cjsatuforc/drone_project/README.md

# drone_project

Building a quadcopter based on the Arduino 101 as a flight controller
