cjsatuforc/drone_project/D$TEMPLATE/Report.tex

%% ----------------------------------------------------------------
%% Report.tex
%% ---------------------------------------------------------------- 
\documentclass{ecsreport}      % Use the Report Style
\graphicspath{{../Figures/}}   % Location of your graphics files
\usepackage{natbib}            % Use Natbib style for the refs.
\usepackage{longtable}         % Use long table to span tables across pages
\hypersetup{colorlinks=false}   % Set to false for black/white printing
\input{Definitions}            % Include your abbreviations
\usepackage{dirtytalk}
\usepackage[utf8]{inputenc}
\usepackage{siunitx}
\usepackage{graphicx}
\usepackage{listings}
\usepackage{color}
\usepackage{appendix}
%\usepackage{minted}
\usepackage{color}
%\usepackage{gensymb}
\usepackage{dirtytalk}
\usepackage{float}

\usepackage{pdfpages}

\definecolor{dkgreen}{rgb}{0,0.6,0}
\definecolor{gray}{rgb}{0.5,0.5,0.5}
\definecolor{mauve}{rgb}{0.58,0,0.82}
\definecolor{lightgray}{rgb}{.9,.9,.9}
\definecolor{darkgray}{rgb}{.4,.4,.4}
\definecolor{purple}{rgb}{0.65, 0.12, 0.82}

\lstset{frame=tb,
  aboveskip=3mm,
  belowskip=3mm,
  showstringspaces=false,
  columns=flexible,
  basicstyle={\small\ttfamily},
  numberstyle=\tiny\color{gray},
  keywordstyle=\color{blue},
  commentstyle=\color{dkgreen},
  stringstyle=\color{mauve},
  breaklines=true,
  breakatwhitespace=true,
  tabsize=3,
  numbers=left
}

\lstdefinelanguage{JavaScript}{
  keywords={break, case, catch, continue, debugger, default, delete, do, else, false, finally, for, function, if, in, instanceof, new, null, return, switch, this, throw, true, try, typeof, var, void, while, with},
  morecomment=[l]{//},
  morecomment=[s]{/*}{*/},
  morestring=[b]',
  morestring=[b]",
  ndkeywords={class, export, boolean, throw, implements, import, this},
  keywordstyle=\color{blue}\bfseries,
  ndkeywordstyle=\color{darkgray}\bfseries,
  identifierstyle=\color{black},
  commentstyle=\color{purple}\ttfamily,
  stringstyle=\color{red}\ttfamily,
  sensitive=true
}

\newcommand\invisiblesection[1]{%
	\refstepcounter{chapter}%
	\addcontentsline{toc}{chapter}{\protect\numberline{\thechapter}#1}%
	\sectionmark{#1}}

%% ----------------------------------------------------------------
\begin{document}

\frontmatter
\pagenumbering{arabic}
\title      {D4 Individual Report:\\ Invention for Transporting Cargo using Helicopter Engineering kNowhow}
\authors    {\texorpdfstring
             {\href{mailto:jw14g15@soton.ac.uk}{Jemma Watson}}
            {Jemma Watson}       
            }
\addresses  {\groupname\\\deptname\\\univname}
\date       {\today}
\subject    {}
\keywords   {}
%\maketitle

\tableofcontents 

%\includepdf[pages={1}, angle=-90, offset=1in -1in]{inventory.pdf}
\includepdf[pages={1},pagecommand={\thispagestyle{plain}\invisiblesection{Inventory Content}}, angle=-90, offset=-1in -1in]{inventory.pdf} \label{Contents Inventory}

\includepdf[pages={1}, angle=-90, offset=1in -1in, pagecommand={\thispagestyle{plain}\invisiblesection{Gantt Chart}}]{Chart.pdf}
\includepdf[pages={1}, offset=-1in -1in, pagecommand={\thispagestyle{plain}\invisiblesection{Transmitter Wiring Diagram}}]{TRANSMITTERcurves_bb.pdf}
\includepdf[pages={1}, offset=1in -1in, pagecommand={\thispagestyle{plain}\invisiblesection{Transmitter Schematics}}]{TRANSMITTER_schem.pdf}
\includepdf[pages={1}, angle=-90, offset=-1in -1in, pagecommand={\thispagestyle{plain}\invisiblesection{Quadcopter Wiring Diagram}}]{drone_bb.pdf}
\includepdf[pages={1}, angle=-90, offset=1in -1in, pagecommand={\thispagestyle{plain}\invisiblesection{Quadcopter Schematics}}]{drone_schem.pdf}

\invisiblesection{Conclusion}\thispagestyle{plain}
\textbf{Conclusion}\\

There have been a number of changes made since my initial proposal; foremost the level of complexity of my drone. In just six weeks since receiving the Arduino 101, I’ve managed to design, build, program, and fly my very own drone. \\
Some of my initial plans were changed along the way. For example, my decision to use a Raspberry Pi connected to an Xbox controller was eventually scrapped in favour of making my own remote control transmitter with some joystick modules, buttons, and an Arduino Uno. I’ve also faced many mechanical issues whilst constructing the drone, resulting in solutions like cutting my own acrylic base plate to attach the Arduino to, and making my own standoffs to house the battery. And of course, what project would be complete without spontaneous hardware failures a week before submission? Fortunately speedy delivery times meant I was able to replace the failed ESC, and get the drone back in the air with a just hours to spare.
At the moment I have a drone that exhibits stable flight. I fully intend on continuing this project, and adding all the cool features I’d planned (what kind of drone doesn’t need a nerf gun?!). The beauty of using the Arduino 101 as a flight controller is the potential to grow and adapt the project in any direction I want to take it. \\
Finally, I would just like to thank everyone involved at Devpost and Intel for giving me the opportunity to do this! I’ve not only expanded my skills as a programmer, but also how to manage my time during a long project – something that will definitely come in useful for my University Electronics 3rd Year project in September!

\end{document}
%% ----------------------------------------------------------------
