cjsatuforc/drone_project/PINS.pptx

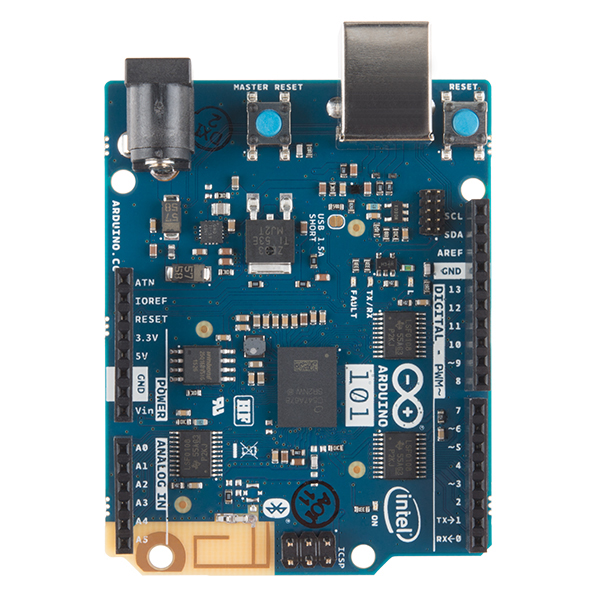
[picture p2: figure]

SCL

SDA

SCK

MISO

MOSI

CE

CSN

INT 2
