cjsatuforc/drone_project/frame/template.pdf

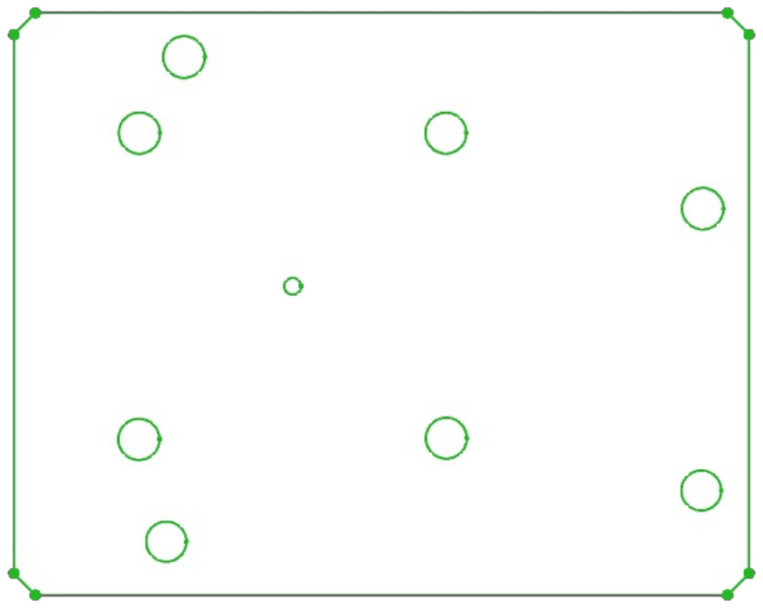
[picture p3: page 1]
