cjsatuforc/drone_project/frame/template2.pdf

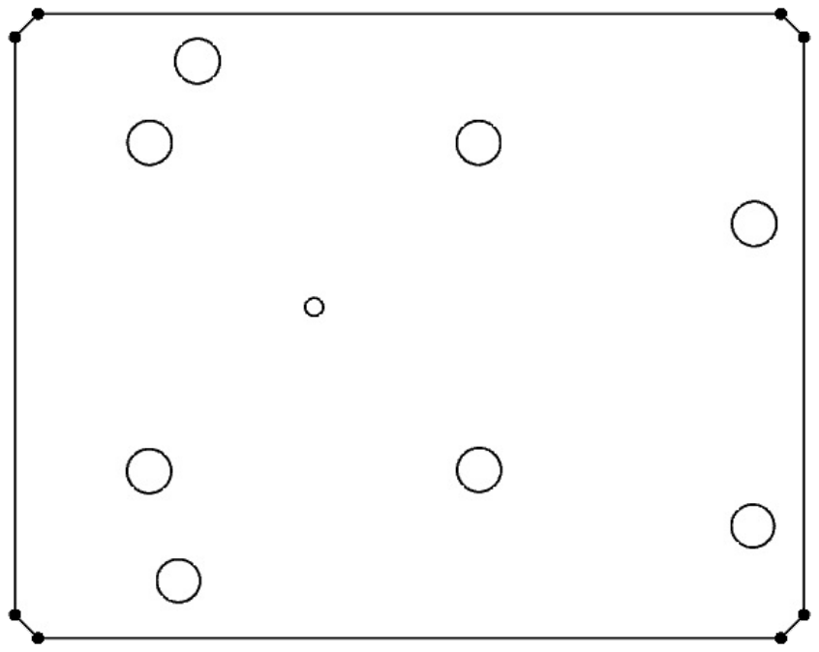
[picture p4: page 1]
