cjsatuforc/drone_project/D$TEMPLATE/figures/display.jpg

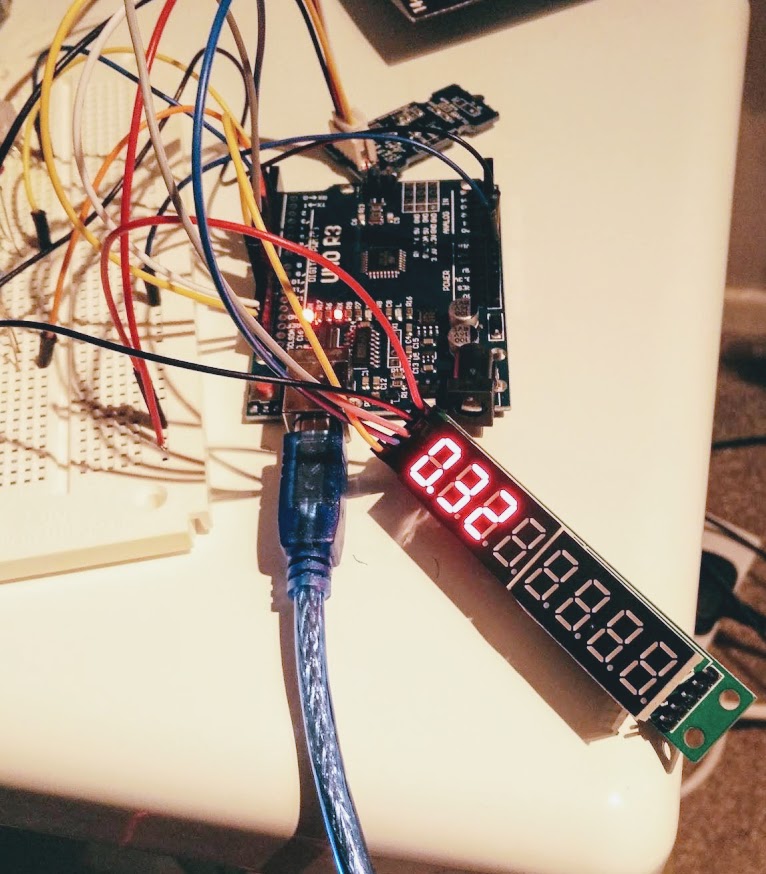
D$TEMPLATE/figures/display.jpg
