cjsatuforc/drone_project/D$TEMPLATE/figures/IMU.png

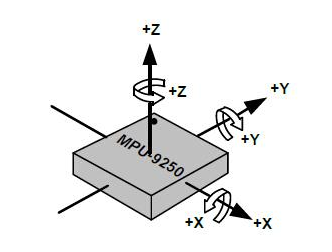
D$TEMPLATE/figures/IMU.png
