cjsatuforc/drone_project/D$TEMPLATE/figures/osc1.png

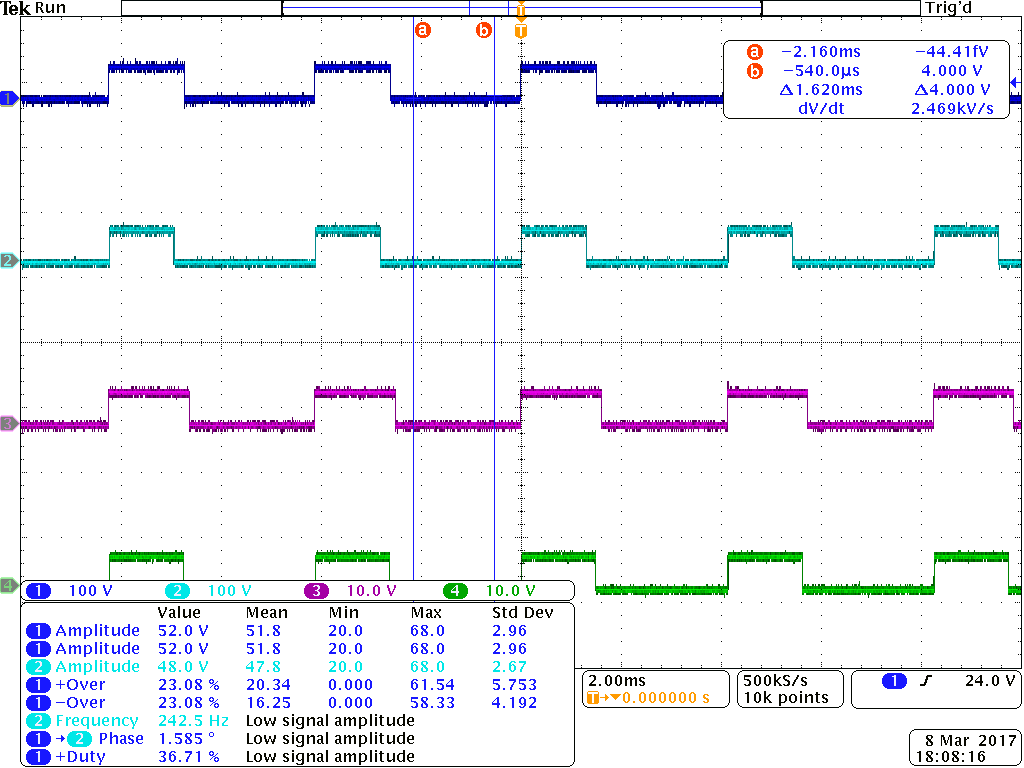
D$TEMPLATE/figures/osc1.png
