cjsatuforc/drone_project/D$TEMPLATE/figures/osc2.png

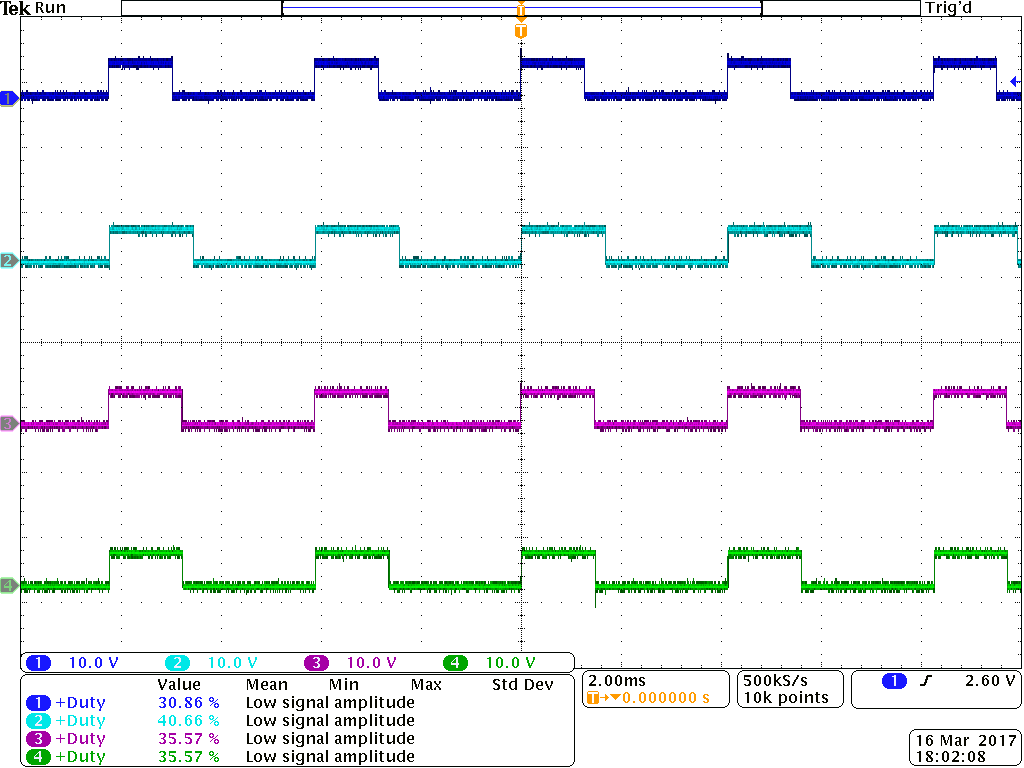
D$TEMPLATE/figures/osc2.png
