cjsatuforc/drone_project/D$TEMPLATE/figures/osc3.png

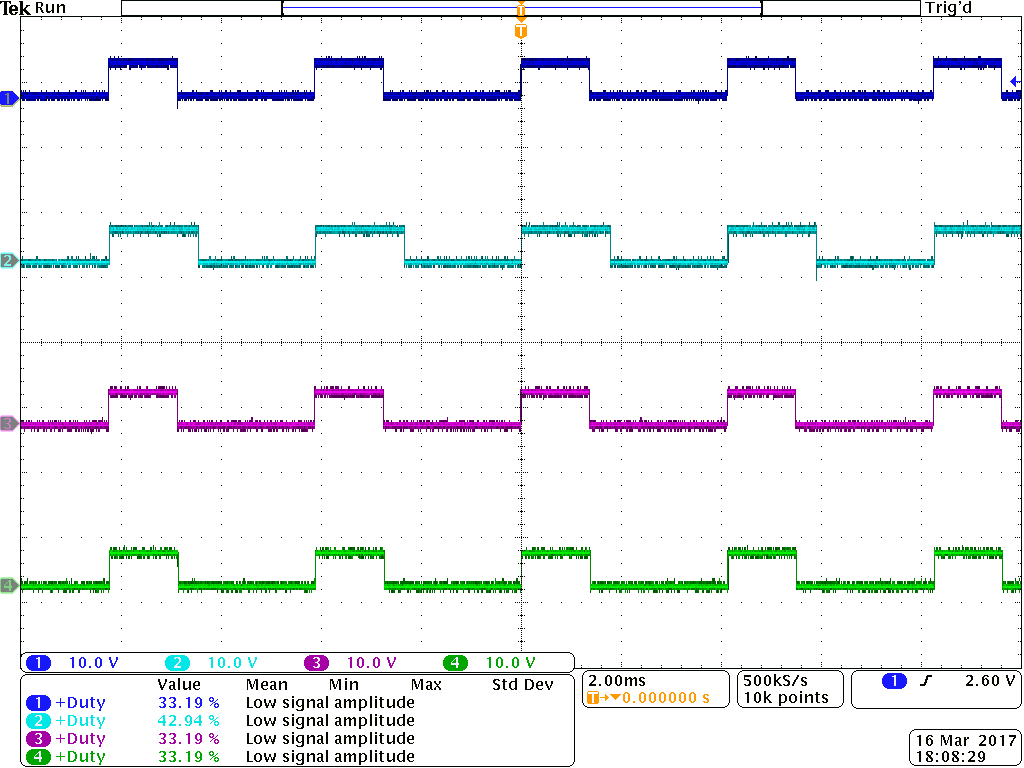
D$TEMPLATE/figures/osc3.png
