cjsatuforc/drone_project/D$TEMPLATE/figures/rpy_maths.png

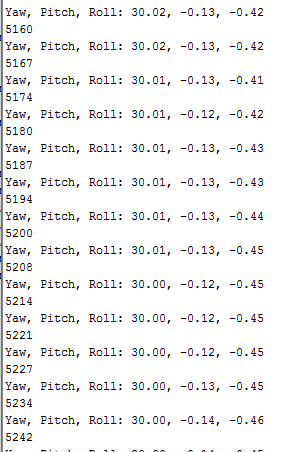
D$TEMPLATE/figures/rpy_maths.png
