cjsatuforc/drone_project/fritz/drone_bb.png

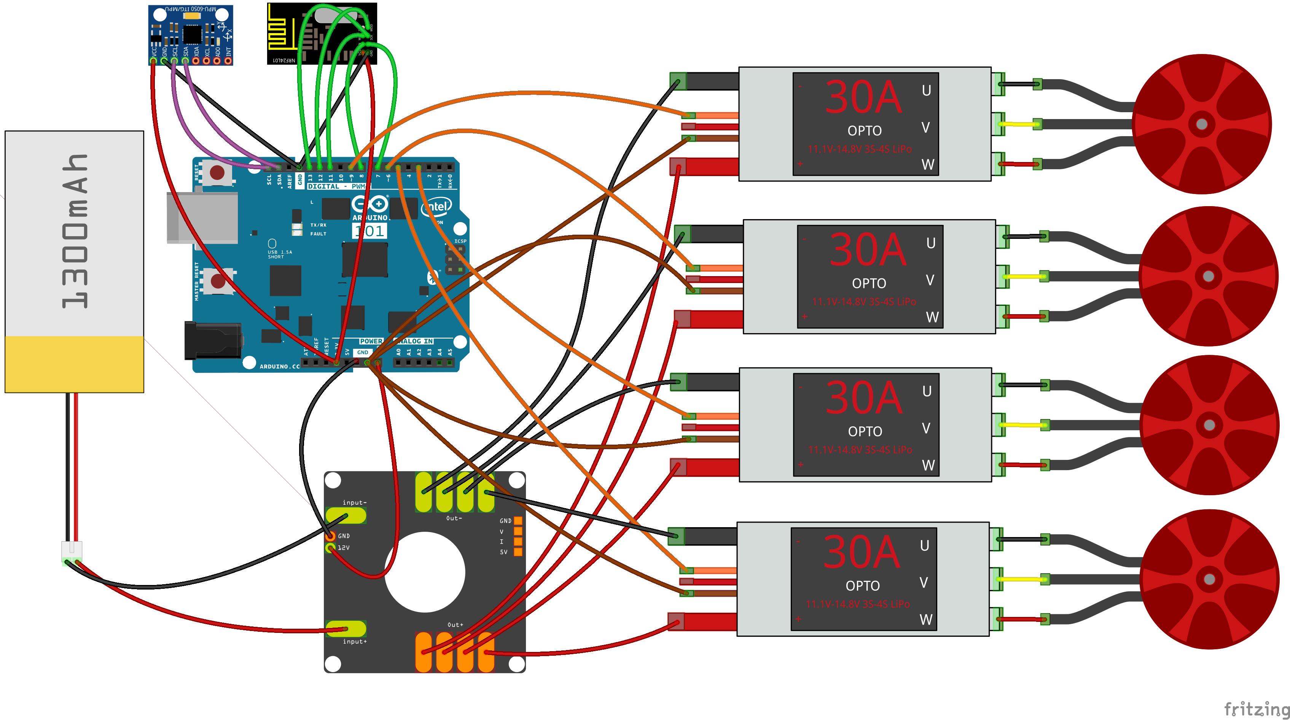
fritz/drone_bb.png
