cjsatuforc/drone_project/fritz/drone_schem.png

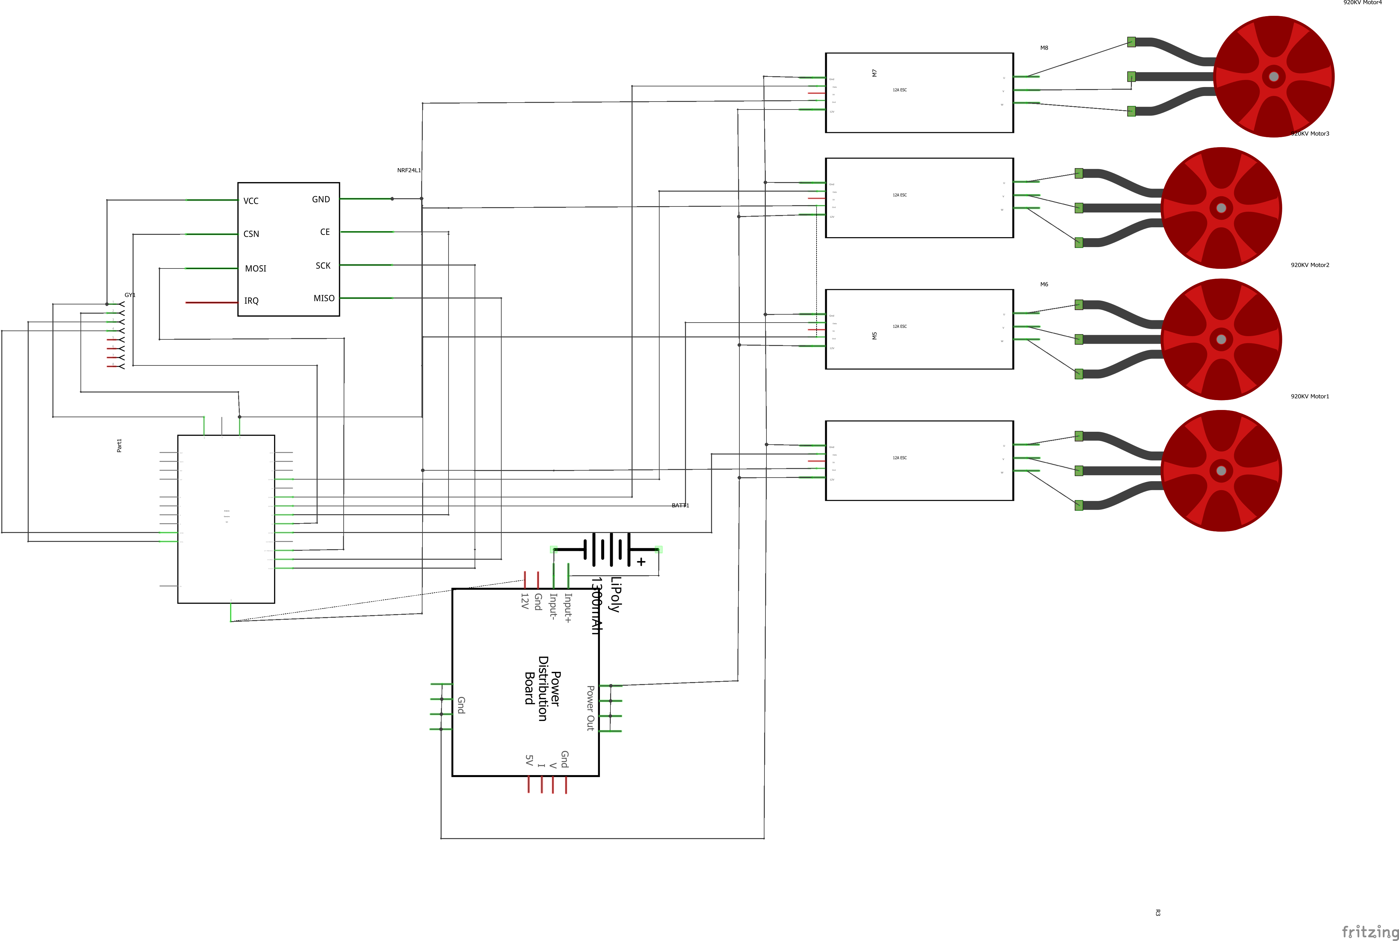
fritz/drone_schem.png
