cjsatuforc/drone_project/fritz/TRANSMITTERcurves_bb.png

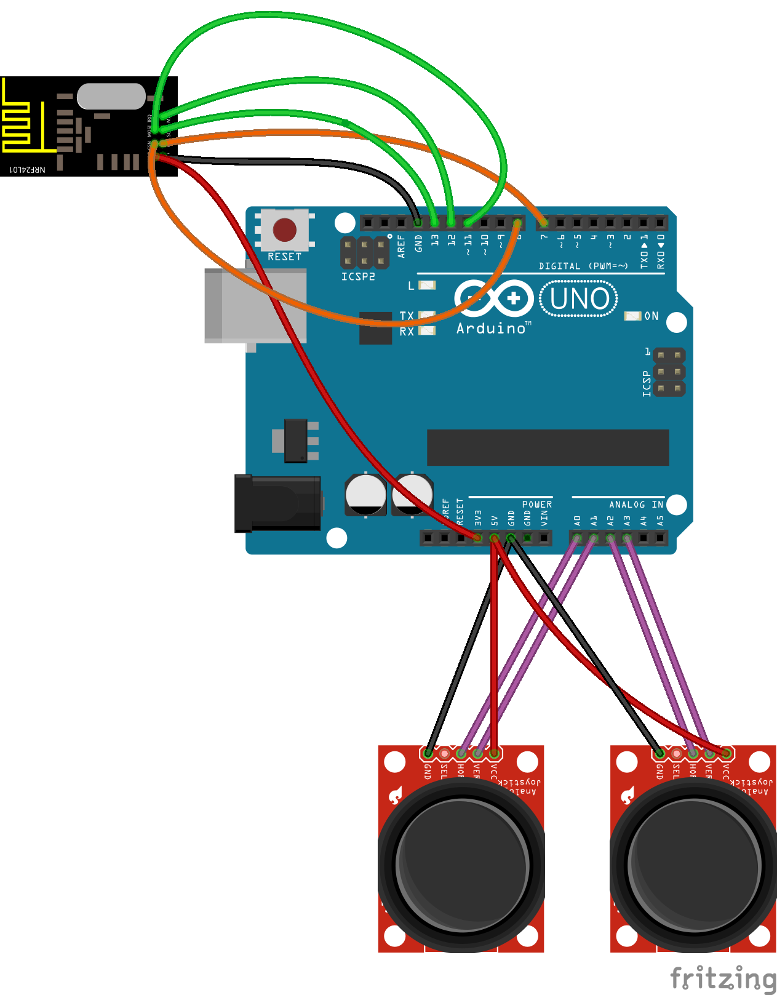
fritz/TRANSMITTERcurves_bb.png
