cjsatuforc/drone_project/fritz/TRANSMITTERcurves_schem.png

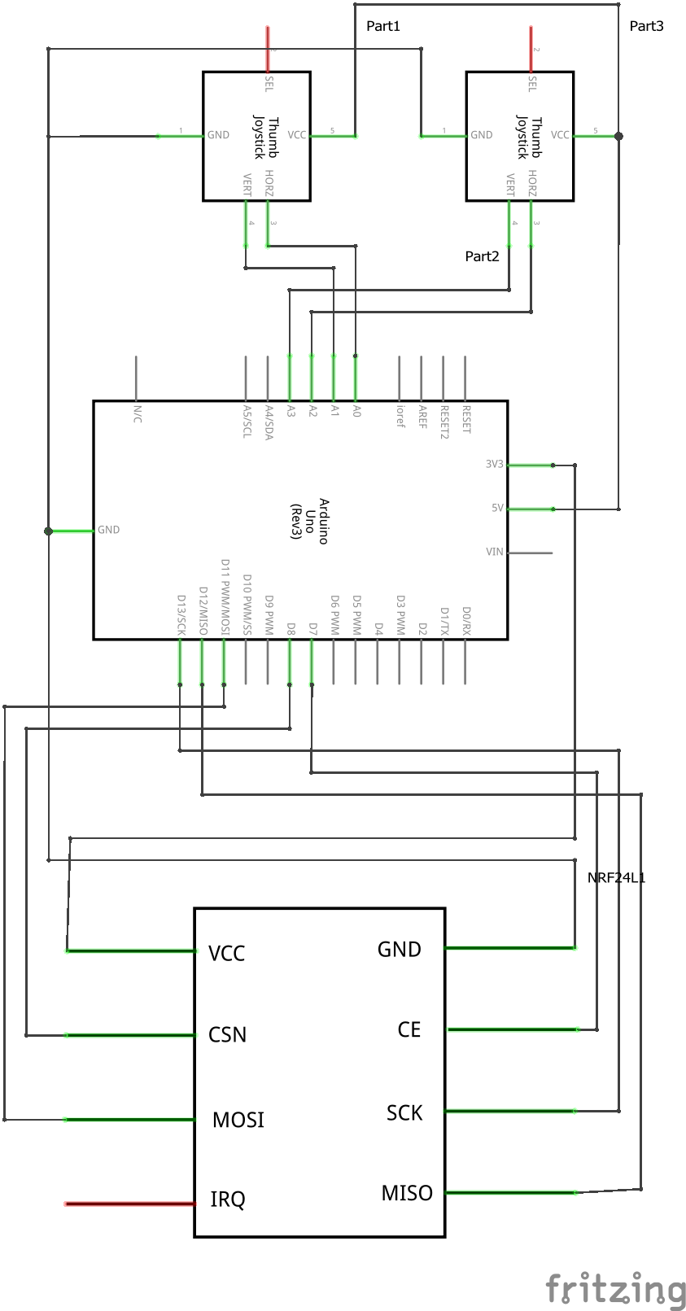
fritz/TRANSMITTERcurves_schem.png
