cjsatuforc/drone_project/inventory.pdf

Content Inventory
Part Description | Link | Quantity | Price per unit
DYS BE1806-2300kv Brushless Motor | https://hobbyking.com/en_us/dys-be1806-2300kv-brushless-multirotor-motor-2s-3s.html 5 | £7.83 | £39.15
Turnigy Multistar 12A ESC | https://hobbyking.com/en_us/mini-blheli-multi-12a-opto.html 5 | £6.67 | £33.35
ZIPPY 2200mAh 3S 25C Lipo | https://hobbyking.com/en_us/zippy-compact-2200mah-3s-25c-lipo-pack.html 1 | £9.71 | £9.71
Turnigy 2-3S Basic Balance Charger | https://hobbyking.com/en_us/turnigy-12v-2-3s-basic-balance-charger.html 1 | £4.03 | £4.03
5030 2-Blade Propeller (CW/CCW pair) | https://hobbyking.com/en_us/gemfan-propeller-5x3-black-cw-ccw-2pcs-1.html 6 | £0.24 | £1.44
Martian III 220 Carbon Fibre Quadcopter Frame Kit | https://www.unmannedtechshop.co.uk/martian-iii-220-carbon-fibre-quadcopter-frame-kit/ 1 | £18.49 | £18.49
Lantian PDB Power Distribution Board | https://www.banggood.com/Lantian-PDB-Power-Distribution-Board-with-BEC-Output-5V-12V-3A-for-CC3C-Naze32-Upgraded-version-p-1076479.html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 1 | £3.61 | £3.61
XT60+ Plug Connector Male | https://www.banggood.com/AMASS-XT60-Plug-Connector-14AWG-10cm-Power-Cable-Wire-p-1060098.html?rmmds=myorder 1 | £1.57 | £1.57
Li-Po Safety Bag | https://www.banggood.com/Li-Po-Battery-Explosion-Proof-Safety-Bag-Charging-Sack-18x23x6cm-p-1017484.html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 1 | £3.08 | £3.08
NRF24L01+ Module Transceiver 2.4Ghz | http://www.ebay.co.uk/itm/NRF24L01-Module-Transceiver-2-4Ghz-RF-Arduino-PI-ARM-Wireless-PACKS-x1-x2- x5/172269443013?ssPageName=STRK%3AMEBIDX%3AIT&var=471089825938&_trksid=p2057872.m2749.l2649 2 | £1.44 | £2.88
MPU9250 9DOF IMU | http://www.ebay.co.uk/itm/9D0F-MPU-9250-SPI-IIC-9-Axis-Attitude-Gyro-Accelerator-Magnetometer- Module-/253026311230?epid=18002490478&hash=item3ae98b1c3e:g:y40AAOSwhQhY7g3v 1 | £4.99 | £4.99
Total spent: | £122.30
Components owned | Quantity
Joystick module | 2
Arduino Uno (for transmitter module) | 1
Arduino 101 (drone module) | 1
