cjsatuforc/drone_project/frame/arduino.FCStd

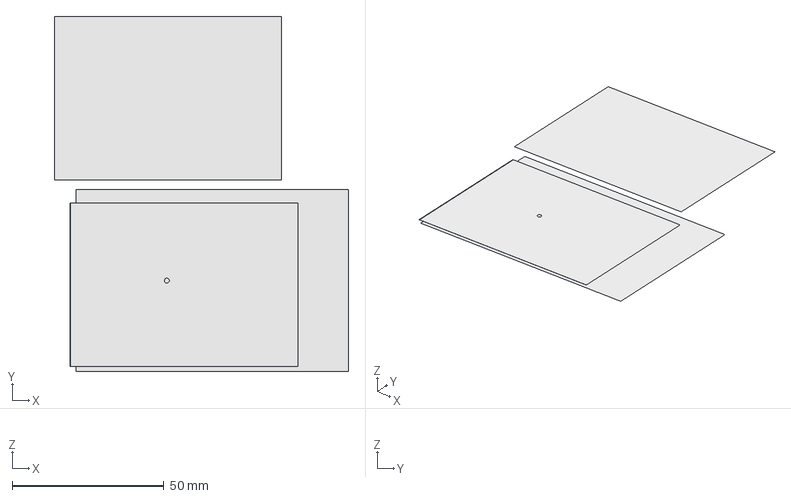
[picture p15: CAD file, 2017-07-04]
frame/arduino.FCStd
97.1 x 117.1 x 0 mm
Circle001
Circle002
Circle003
Circle004
Circle005
Circle006
Clone of Circle001 (2D)
Clone of Circle002 (2D)
Circle007
Circle008
Circle009
Circle010
Circle011
Rectangle
Rectangle001
Clone of Rectangle001 (2D)
Clone of Clone of Rectangle001 (2D) (2D)
Rectangle002
Rectangle003
