cjsatuforc/drone_project/frame/layer.FCStd

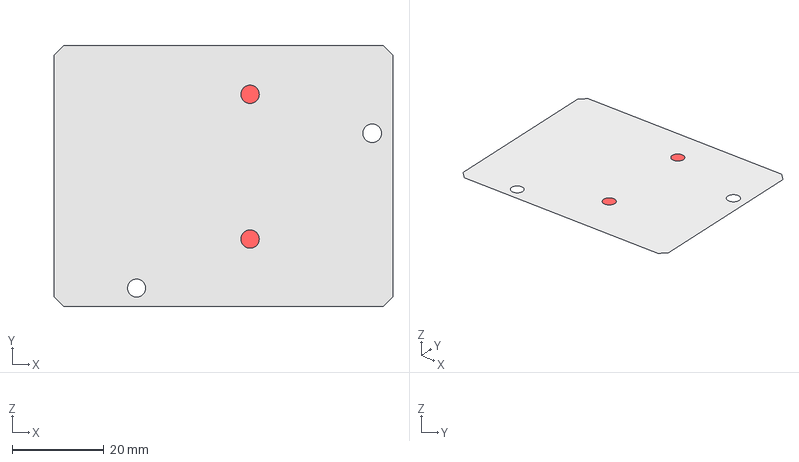
[picture p16: CAD file, 2017-07-04]
frame/layer.FCStd
74.0 x 57.0 x 0 mm
Circle013
Circle014
Circle015
Circle016
Circle019
Circle020
Circle021
Circle022
Circle023
Rectangle003
