cjsatuforc/drone_project/D$TEMPLATE/Report.pdf

# Contents

1 Inventory Content | 2
2 Gantt Chart | 3
3 Transmitter Wiring Diagram | 4
4 Transmitter Schematics | 5
5 Quadcopter Wiring Diagram | 6
6 Quadcopter Schematics | 7
7 Conclusion | 8

Part Description

### Content Inventory

Link Quantity Price per unit

DYS BE1806-2300kv Brushless Motor https://hobbyking.com/en_us/dys-be1806-2300kv-brushless-multirotor-motor-2s-3s.html 5 £7.83 £39.15

Turnigy Multistar 12A ESC https://hobbyking.com/en_us/mini-blheli-multi-12a-opto.html 5 £6.67 £33.35

ZIPPY 2200mAh 3S 25C Lipo https://hobbyking.com/en_us/zippy-compact-2200mah-3s-25c-lipo-pack.html 1 £9.71 £9.71

Turnigy 2-3S Basic Balance Charger https://hobbyking.com/en_us/turnigy-12v-2-3s-basic-balance-charger.html 1 £4.03 £4.03

5030 2-Blade Propeller (CW/CCW pair) https://hobbyking.com/en_us/gemfan-propeller-5x3-black-cw-ccw-2pcs-1.html 6 £0.24 £1.44

Martian III 220 Carbon Fibre Quadcopter Frame Kit https://www.unmannedtechshop.co.uk/martian-iii-220-carbon-fibre-quadcopter-frame-kit/ 1 £18.49 £18.49

Lantian PDB Power Distribution Board https://www.banggood.com/Lantian-PDB-Power-Distribution-Board-with-BEC-Output-5V-12V-3A-for-CC3C-Naze32-Upgraded-version-p-1076479.html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 1 £3.61 £3.61

XT60+ Plug Connector Male https://www.banggood.com/AMASS-XT60-Plug-Connector-14AWG-10cm-Power-Cable-Wire-p-1060098.html?rmmds=myorder 1 £1.57 £1.57

Li-Po Safety Bag https://www.banggood.com/Li-Po-Battery-Explosion-Proof-Safety-Bag-Charging-Sack-18x23x6cm-p-1017484.html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 1 £3.08 £3.08

NRF24L01+ Module Transceiver 2.4Ghz http://www.ebay.co.uk/itm/NRF24L01-Module-Transceiver-2-4Ghz-RF-Arduino-PI-ARM-Wireless-PACKS-x1-x2- x5/172269443013?ssPageName=STRK%3AMEBIDX%3AIT&var=471089825938&_trksid=p2057872.m2749.l2649 2 £1.44 £2.88

MPU9250 9DOF IMU http://www.ebay.co.uk/itm/9D0F-MPU-9250-SPI-IIC-9-Axis-Attitude-Gyro-Accelerator-Magnetometer- Module-/253026311230?epid=18002490478&hash=item3ae98b1c3e:g:y40AAOSwhQhY7g3v 1 £4.99 £4.99

Total spent: £122.30

### Components owned Quantity

Joystick module 2

Arduino Uno (for transmitter module) 1

Arduino 101 (drone module) 1

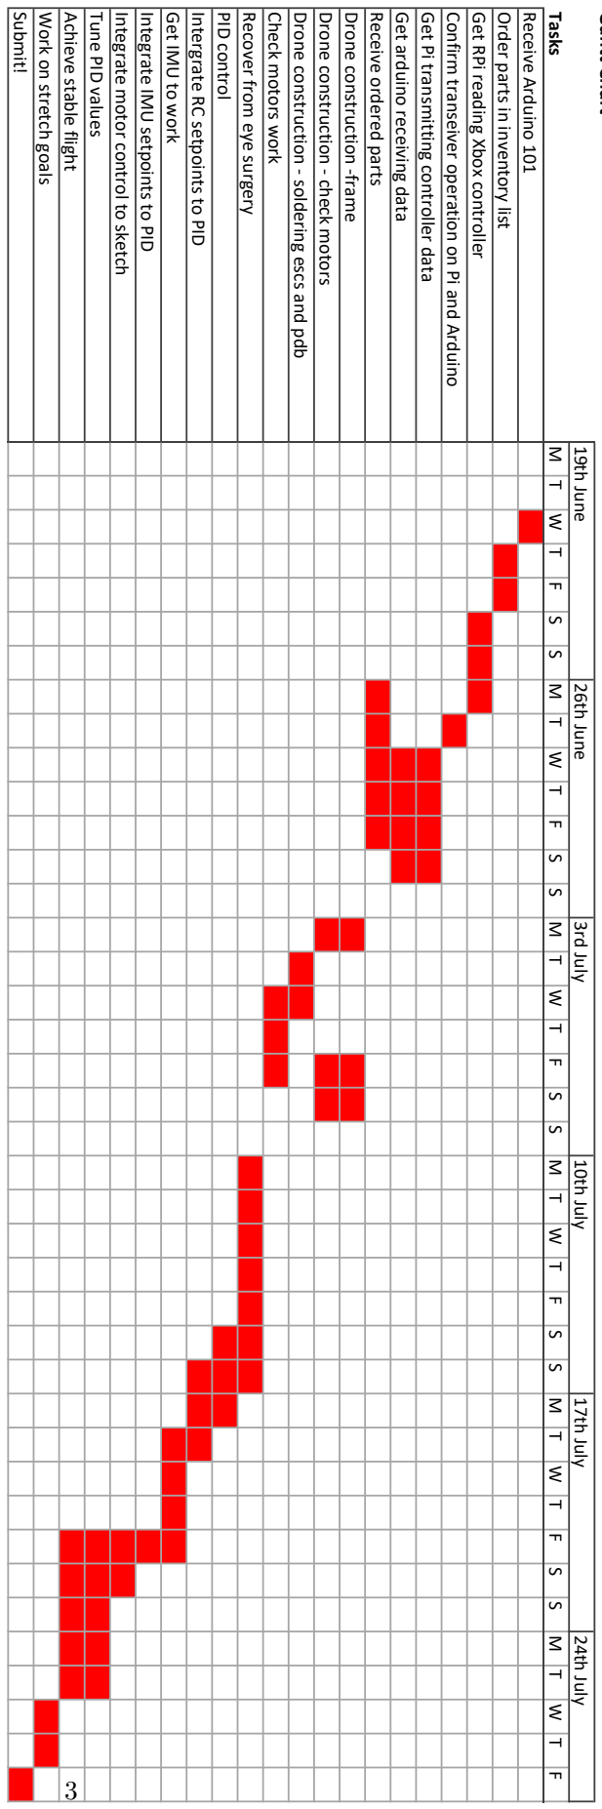
[picture p17: figure]
Submit!; Work on stretch goals; Achieve stable flight; Tune PID values; Integrate motor control to sketch; Integrate IMU setpoints to PID; Get IMU to work; Intergrate RC setpoints to PID; PID control; Recover from eye surgery; Check motors work; Drone construction - check motors; Drone construction -frame; Receive ordered parts; Get arduino receiving data; Get Pi transmitting controller data; Get RPi reading Xbox controller; Order parts in inventory list; Receive Arduino 101

Gantt Chart

19th June 26th June 3rd July 10th July 17th July 24th July

Tasks M T W T F S S M T W T F S S M T W T F S S M T W T F S S M T W T F S S M T W T F

Drone construction - soldering escs and pdb

Confirm transeiver operation on Pi and Arduino

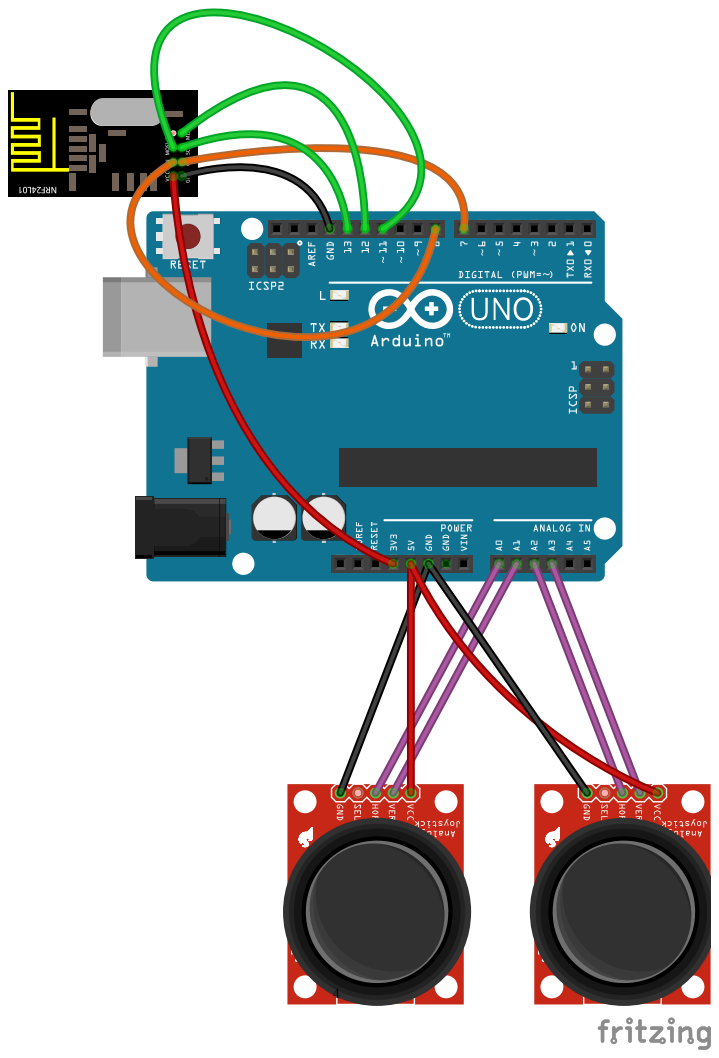
[picture p18: page 4]

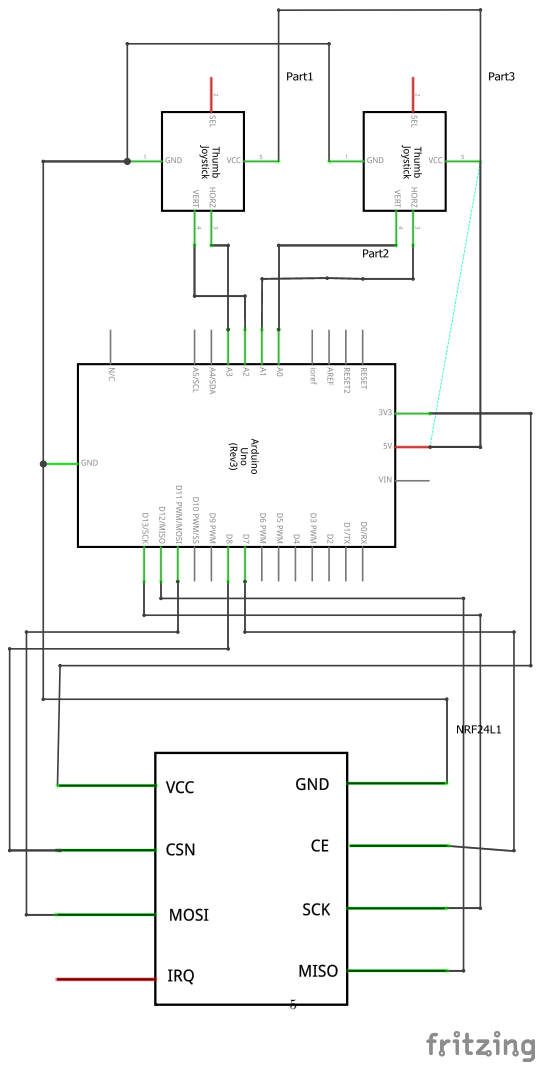
[picture p19: page 5]

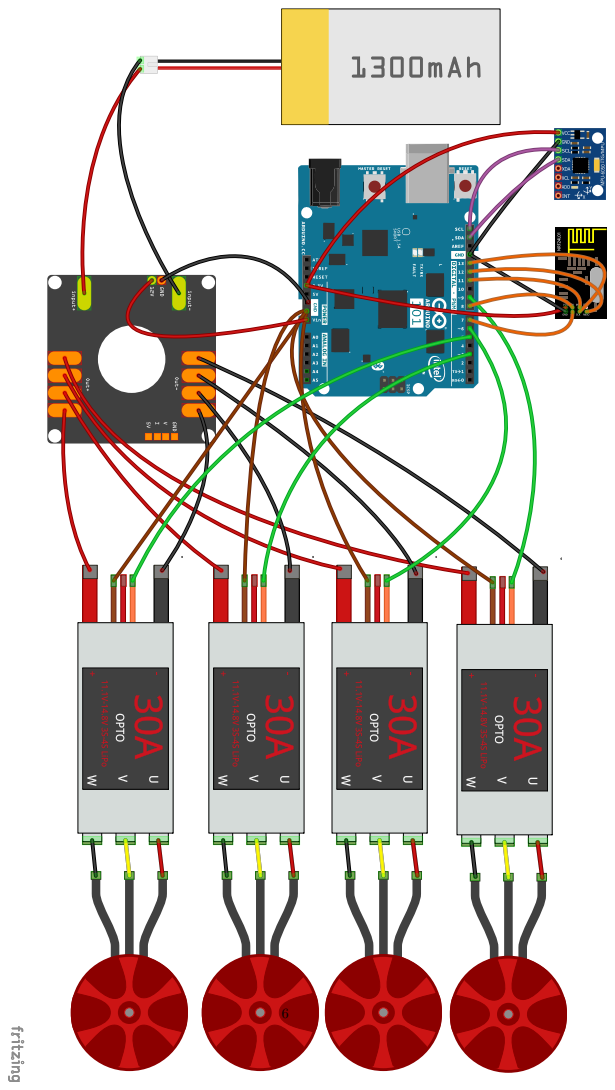
[picture p20: page 6]

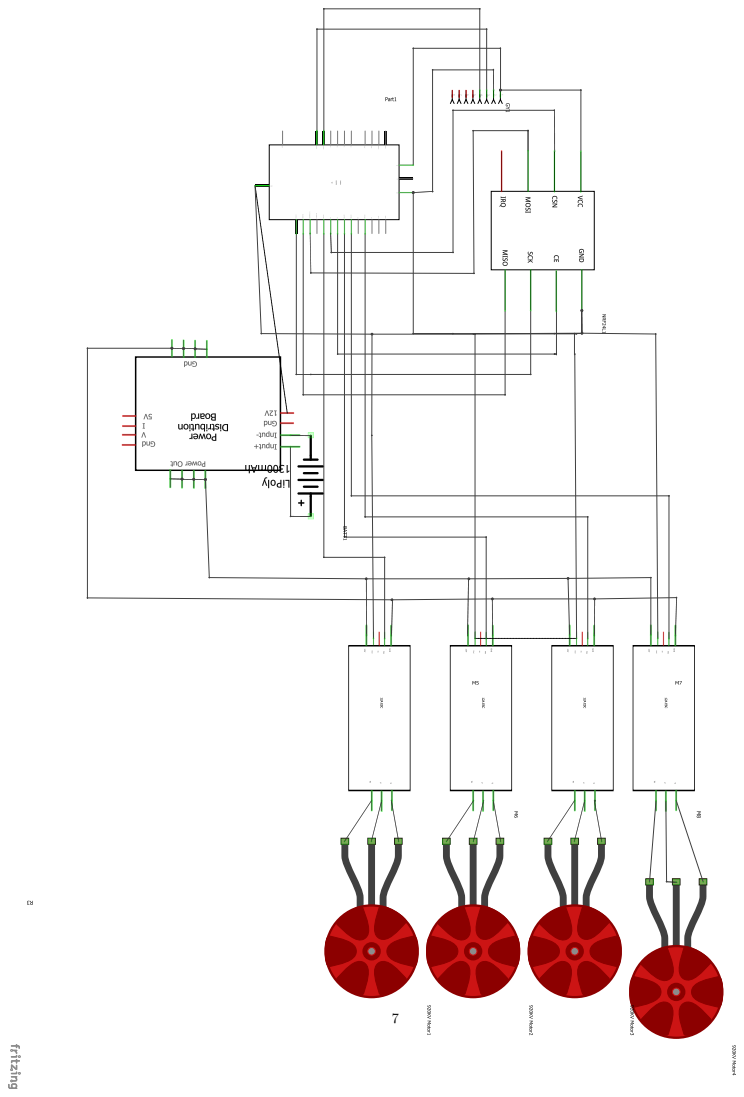
[picture p21: page 7]

Conclusion

There have been a number of changes made since my initial proposal; foremost the level of complexity of my drone. In just six weeks since receiving the Arduino 101, I’ve managed to design, build, program, and fly my very own drone.
Some of my initial plans were changed along the way. For example, my decision to use a Raspberry Pi connected to an Xbox controller was eventually scrapped in favour of making my own remote control transmitter with some joystick modules, buttons, and an Arduino Uno. I’ve also faced many mechanical issues whilst constructing the drone, resulting in solutions like cutting my own acrylic base plate to attach the Arduino to, and making my own standoffs to house the battery. And of course, what project would be complete without spontaneous hardware failures a week before submission? Fortunately speedy delivery times meant I was able to replace the failed ESC, and get the drone back in the air with a just hours to spare. At the moment I have a drone that exhibits stable flight. I fully intend on continuing this project, and adding all the cool features I’d planned (what kind of drone doesn’t need a nerf gun?!). The beauty of using the

Arduino 101 as a flight controller is the potential to grow and adapt the project in any

direction I want to take it.
Finally, I would just like to thank everyone involved at Devpost and Intel for giving me the opportunity to do this! I’ve not only expanded my skills as a programmer, but also how to manage my time during a long project – something that will definitely come in useful for my University Electronics 3rd Year project in September!
