cjsatuforc/drone_project/D$TEMPLATE/drone_schem.pdf

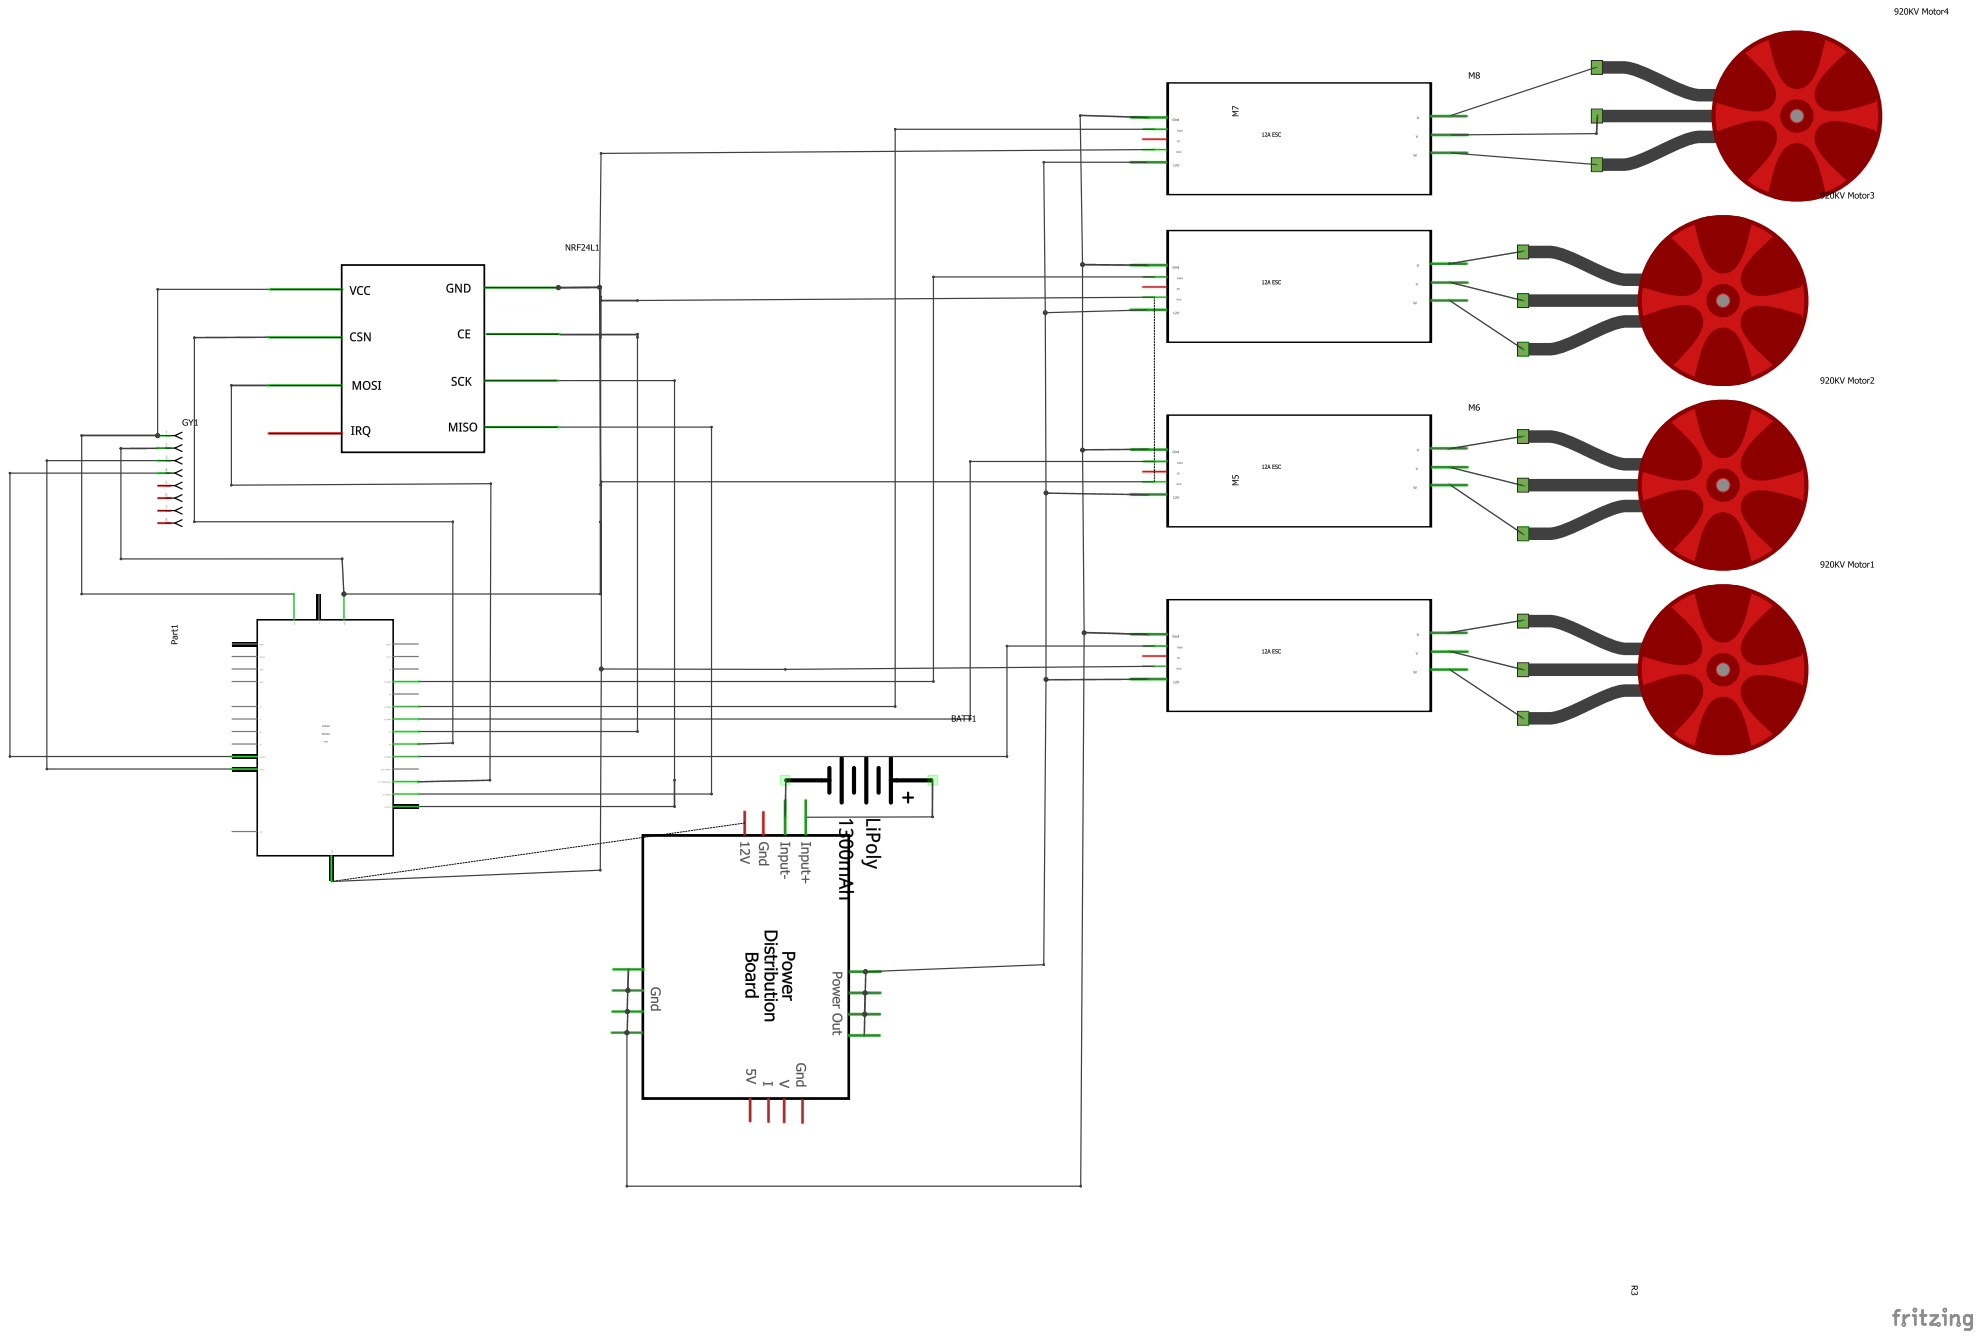
[picture p22: page 1]
