cjsatuforc/drone_project/D$TEMPLATE/drone_bb.pdf

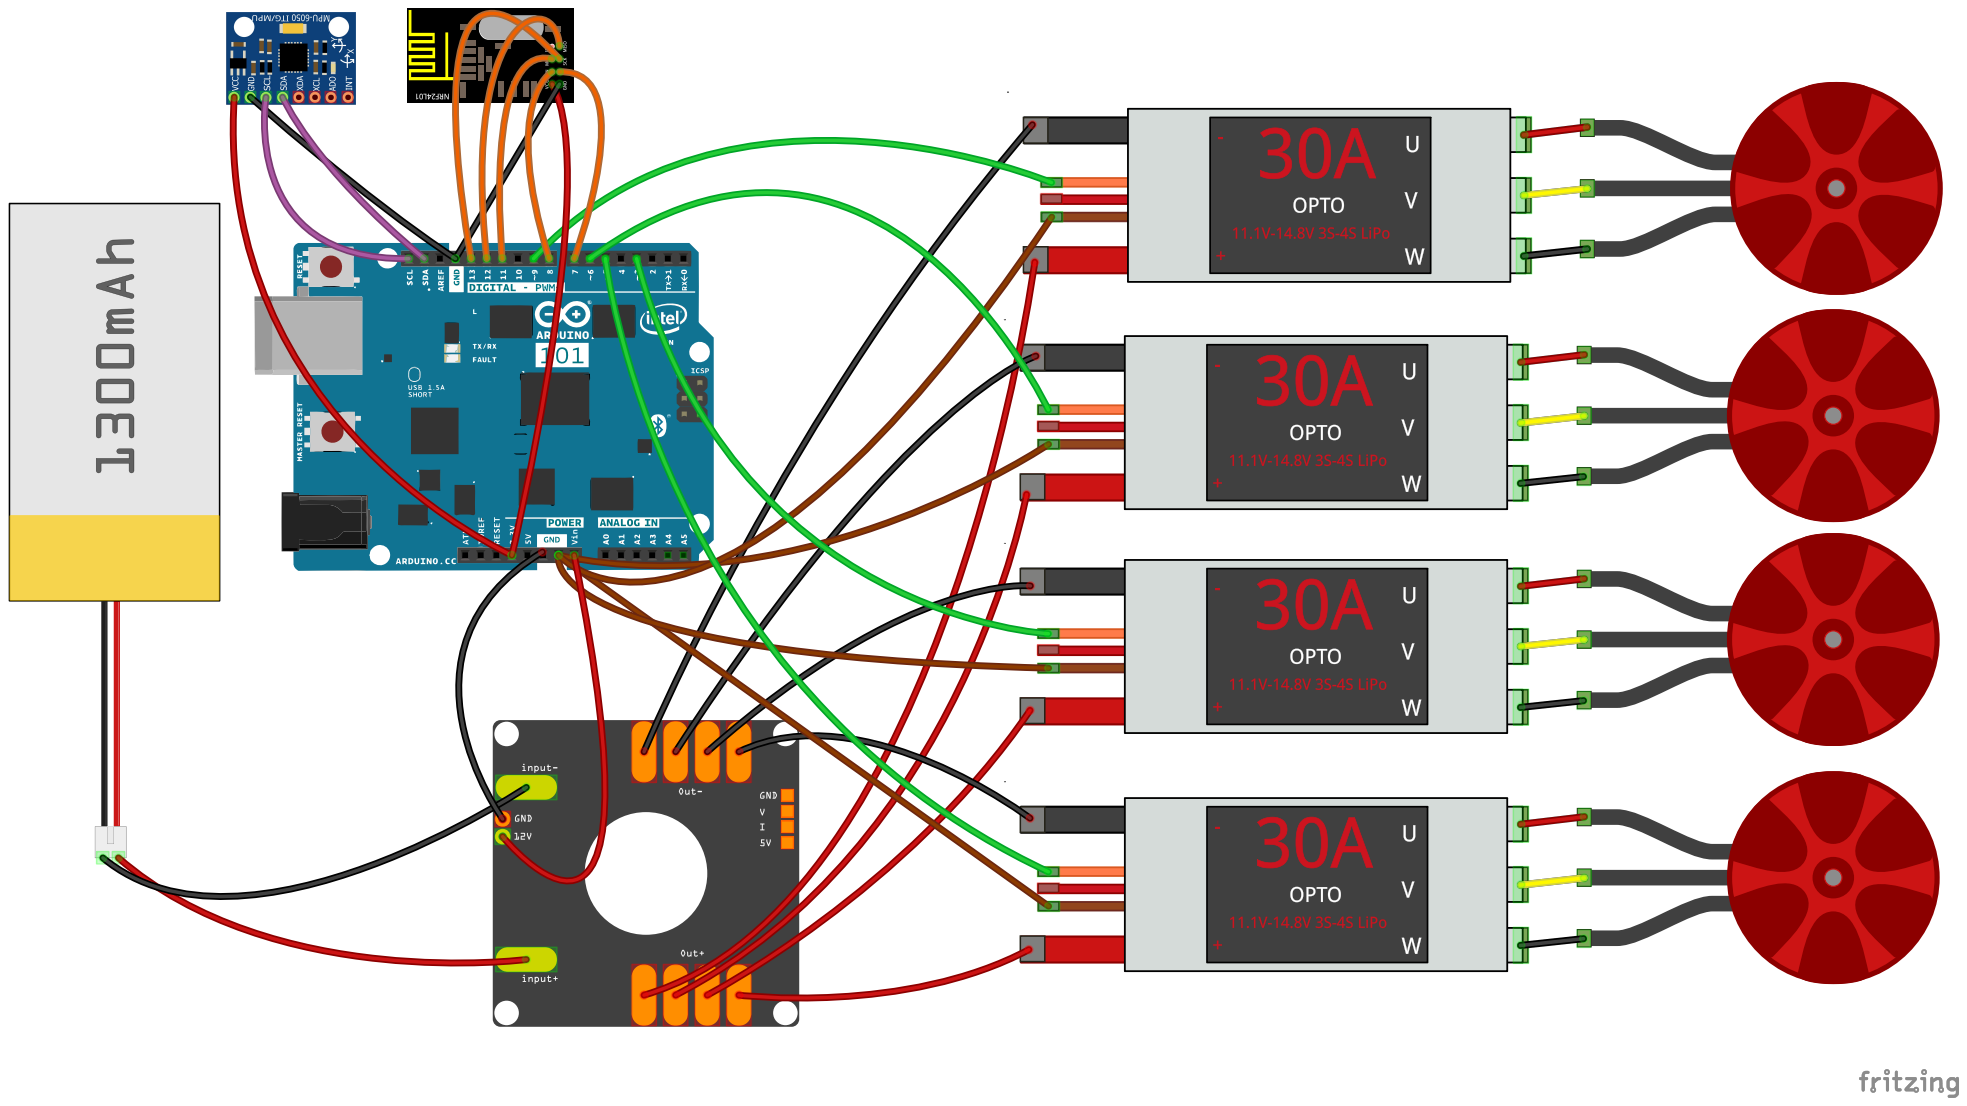
[picture p23: page 1]
