cjsatuforc/drone_project/D$TEMPLATE/TRANSMITTER_schem.pdf

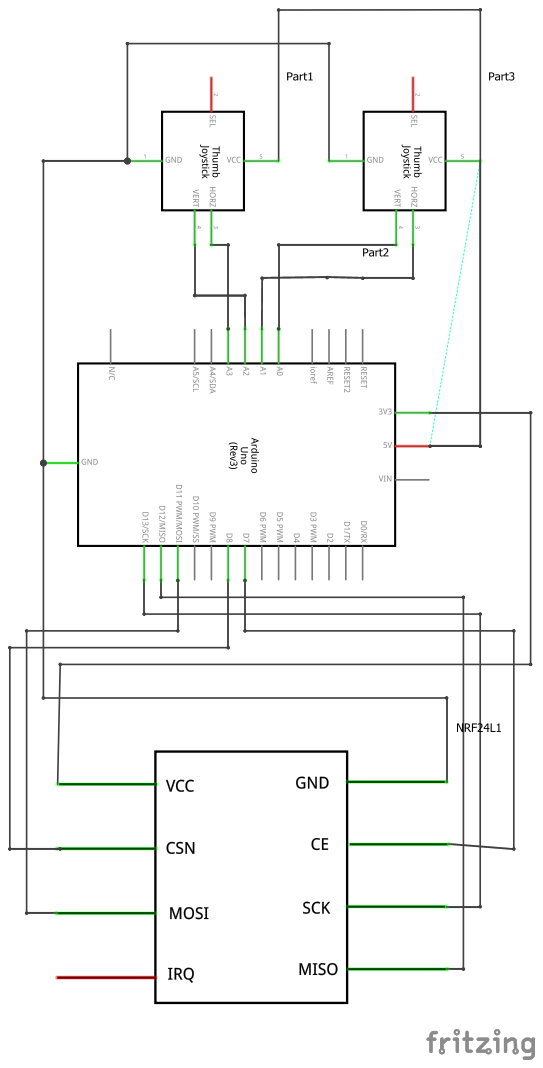
[picture p24: page 1]
