cjsatuforc/drone_project/D$TEMPLATE/TRANSMITTERcurves_bb.pdf

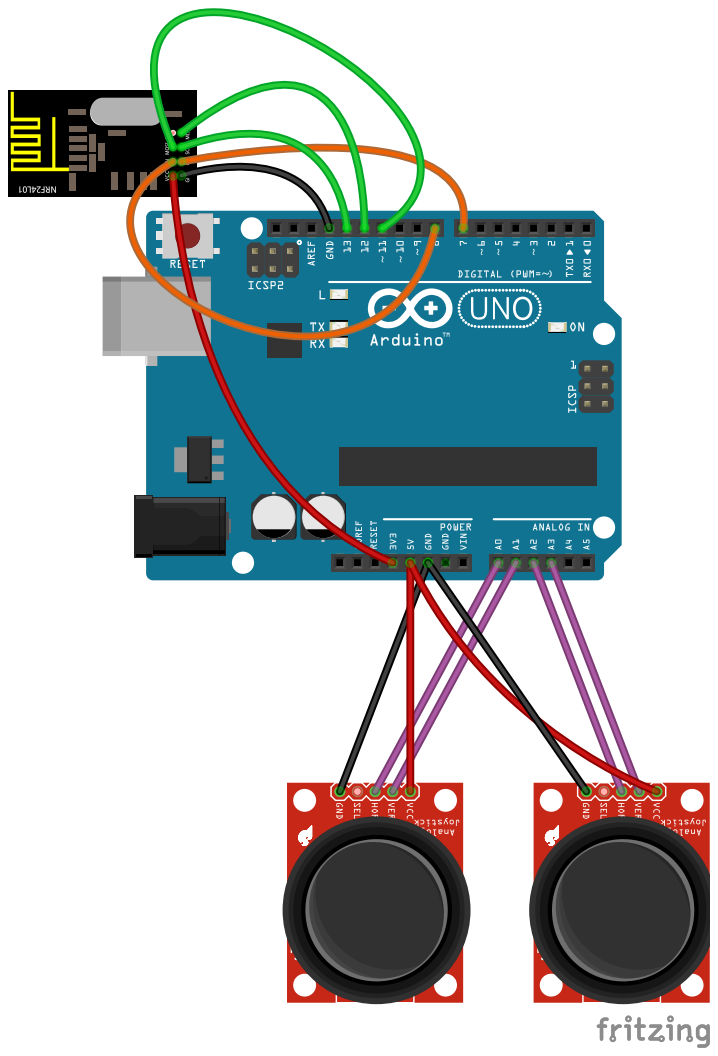
[picture p25: page 1]
