cjsatuforc/drone_project/fritz/TRANSMITTER_bb.pdf

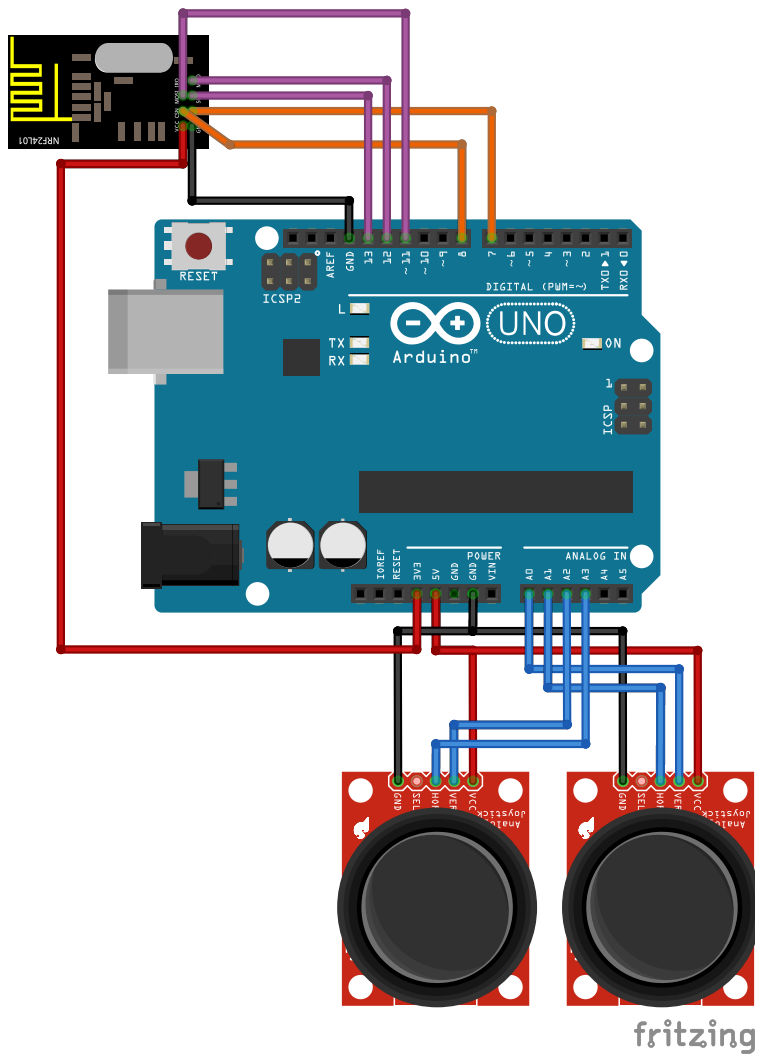
[picture p26: page 1]
