cjsatuforc/drone_project/frame/template3.pdf

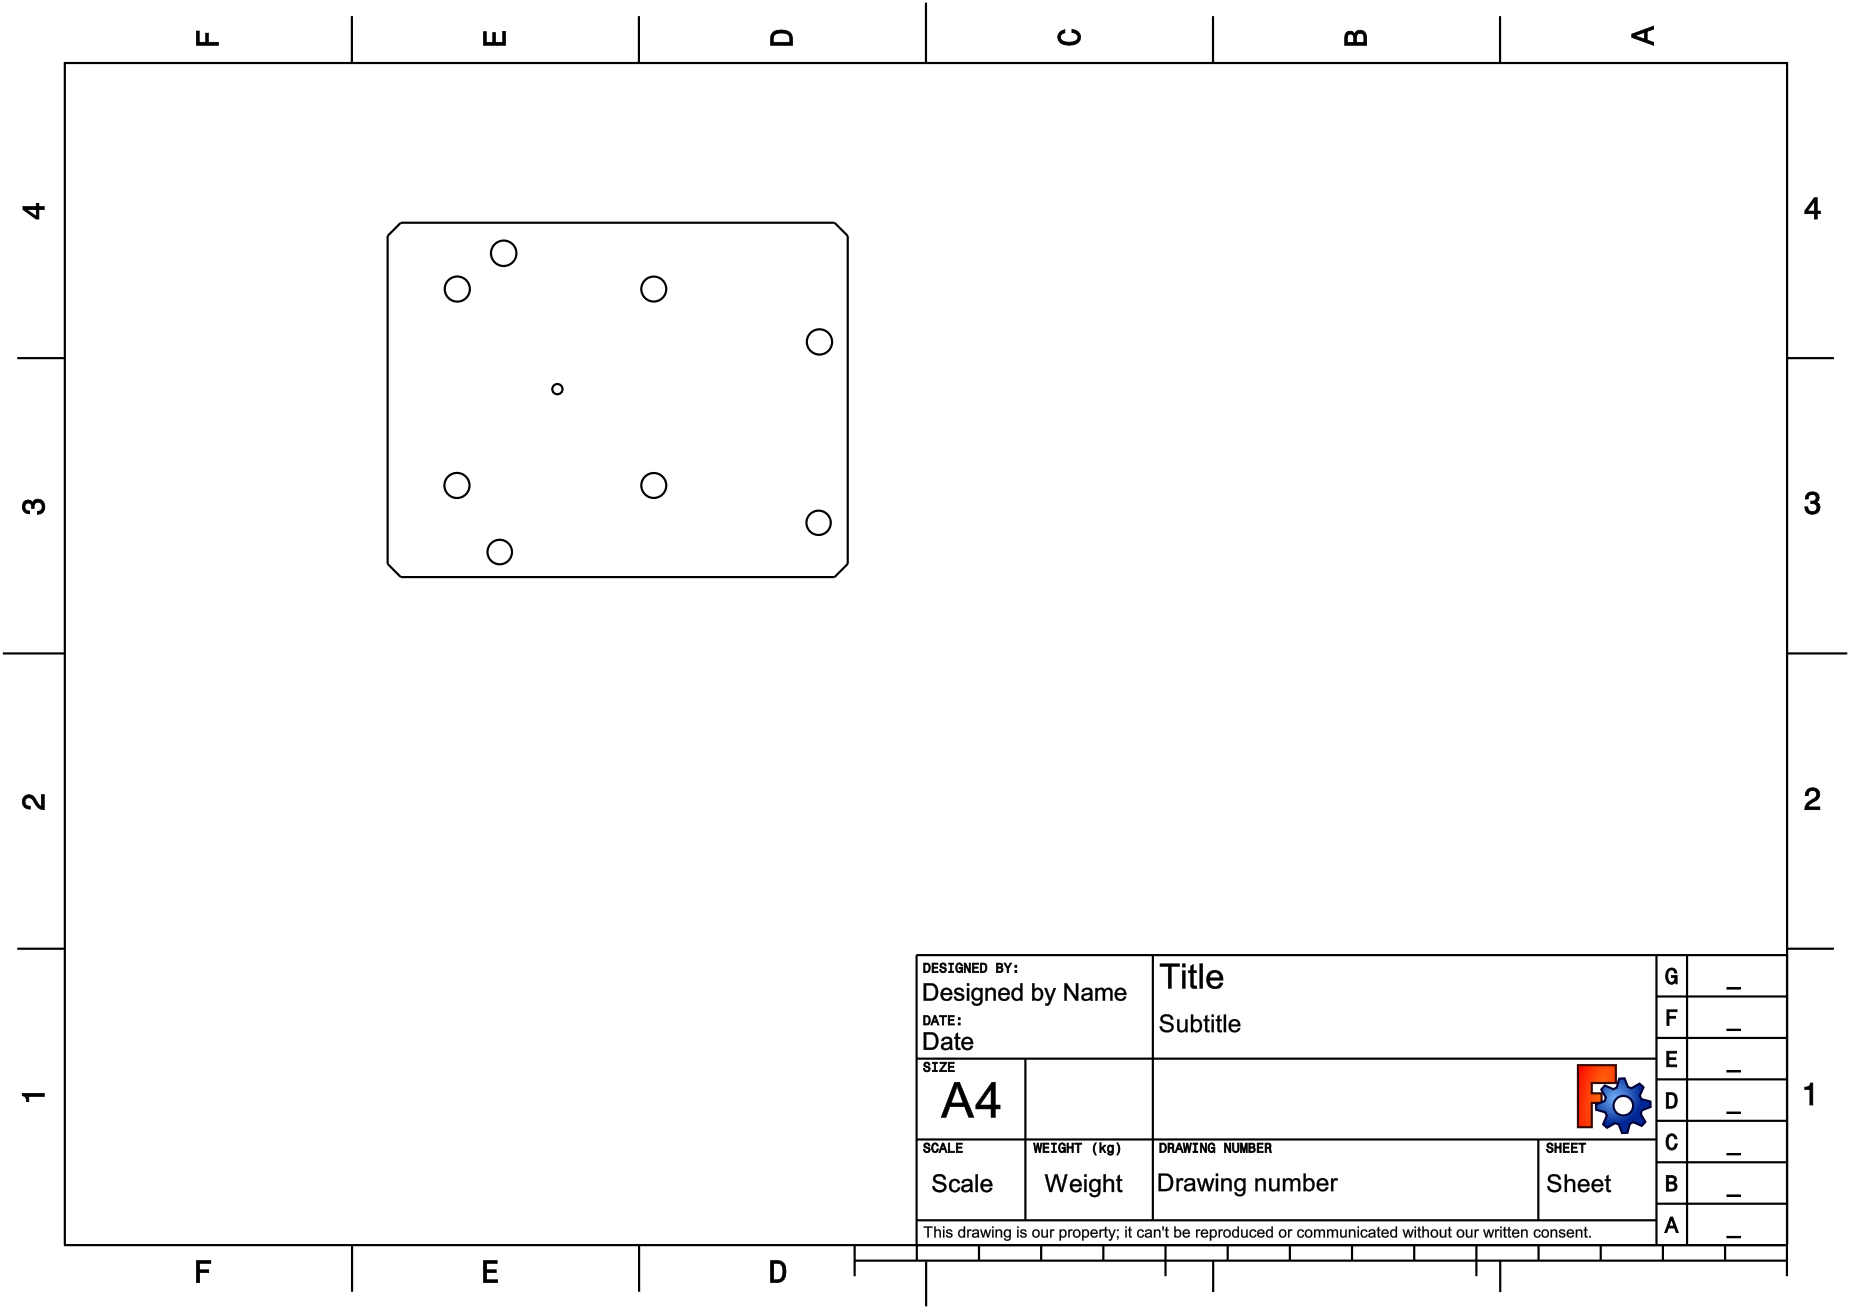
[picture p27: page 1]
