cjsatuforc/drone_project/(list of files, drawings)

Other design files:
drone.fzz
fritz/drone.fzz
fritz/TRANSMITTER.fzz
fritz/TRANSMITTERcurves.fzz
