cjsatuforc/drone_project/Arduino/PID_rx_IMU_PIDchange/definitions.h

#ifndef _DEFINITIONS_H
#define _DEFINITIONS_H


// #include <asm/types.h> //needs?





#define JS1_X 0x00 //axis[0]
#define JS1_Y 0x01 //axis[1]
#define JS2_X 0x02 //axis[3]
#define JS2_Y 0x03 //axis[4]
#define LT 0x04 //axis[2]
#define RT 0x05 //axis[5]
#define CP_X 0x06 //axis[6]
#define CP_Y 0x07 //axis[7]

#define BUTTON_A 0x08 //button[0]
#define BUTTON_B 0x09 //button[1]
#define BUTTON_X 0x0A //button[2]
#define BUTTON_Y 0x0B //button[3]
#define BUTTON_LB 0x0C //button[4]
#define BUTTON_RB 0x0D //button[5]
#define BUTTON_BACK 0x0E //button[6]
#define BUTTON_START 0x0F //button[7]
#define BUTTON_XBOX 0x10 //button[8]


#endif /* _DEFINITIONS_H */
