cjsatuforc/drone_project/(commit log)

2017-06-25 joystickTEST.c printout completed
2017-06-30 RPi transmitetr code and library and Arduino library working
2017-06-30 simple RPi transmit code (sending millis) working with GettingStarted Arduino code
2017-06-30 Cut down Arduino script that works with the RPi
2017-07-01 RPi and Arduino code transmitting joystick data. Axis good, buttons are broken
    [Rx.ino, definitions.h, js_transmit.cpp, transmit.cpp]
2017-07-02 added code to divide by 1000 on transitter end, to clear up jitter and added a deadzone for controller. Works much betetr now. Axis are fine, buttons are much betetr, but still get stuck at 1 occasio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
    [Rx.ino, js_transmit_imp.cpp]
2017-07-04 CAD frame layer design and arduino code for IMU test
    [arduino.FCStd, layer.FCStd]
2017-07-07 arduino cutdown IMU code
2017-07-20 PID with rx
2017-07-20 PID with rx working kinda
2017-07-21 IMU code in main doc
2017-07-21 IMU stuff integrated but barely working. interrupt version
2017-07-22 all integrated, 1st v. works at first, then transmitter starts intermittently failing, causing arduino loop to become very laggy (approx 300ms)
    [PID_rx_IMU.ino, drone.cpp, drone.h, servo_test.ino]
2017-07-23 changes dad made (still doesnt work ;_;). going to abandon RPi and set up tx on arduino uno
2017-07-23 getting started arduino sketches
2017-07-24 PID_rx_IMU code -- periodically freezes and hangs, and is 100 or 50Hz dependant on position of resetFIFO()
    [IMU_without_interrupts.ino, PID_rx_IMU.ino, definitions.h, drone.cpp, drone.h]
2017-07-24 reading raw values crashes
    [MPU6050_raw.ino, PID_rx_IMU.ino]
2017-07-26 fritzing and inventory
    [TRANSMITTER.fzz, TRANSMITTERcurves.fzz, drone.fzz, inventory.xlsx]
2017-07-26 gantt chart from laptop
    [drone gantt chart.xlsx]
2017-07-27 changing PID tuning values through transmitter
2017-07-27 report with inv, chart, wiring diags and dodgy conc
    [drone gantt chart.xlsx, inventory.xlsx]
